ryan-vance/led-chess-board/gallery/Chess Board Final Picture.JPG

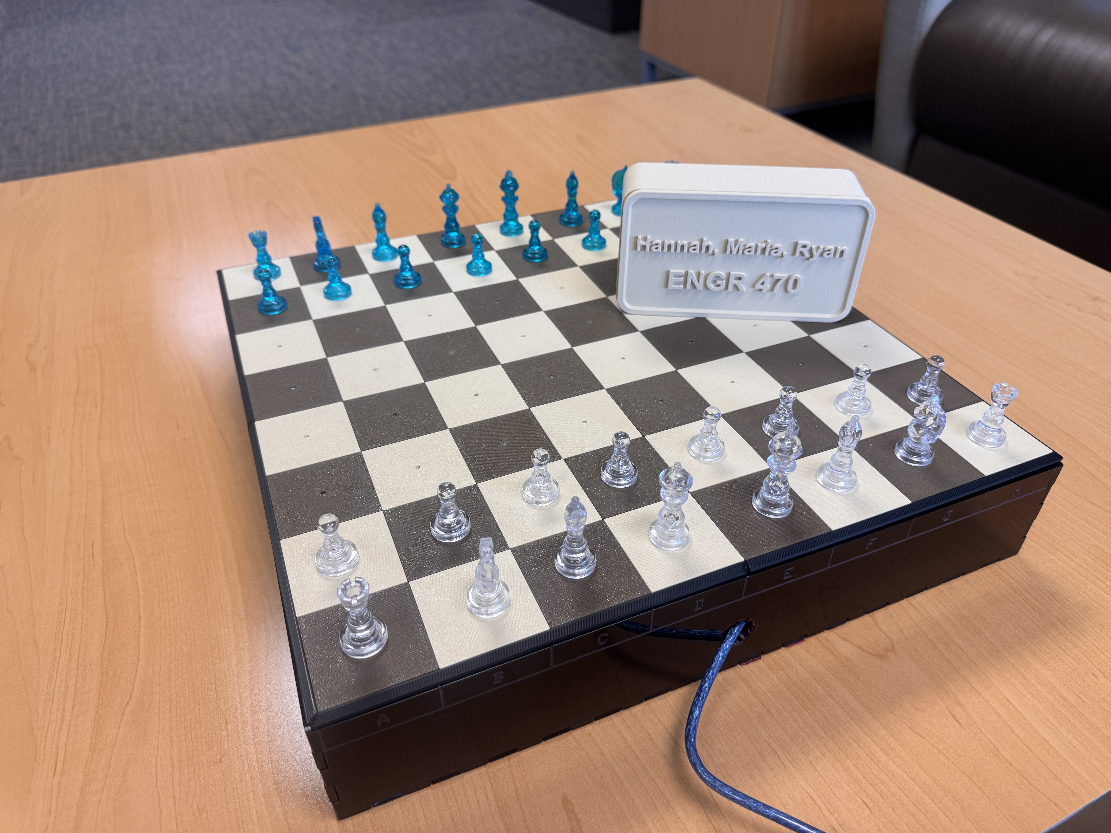
gallery/Chess Board Final Picture.JPG
