ryan-vance/led-chess-board/docs/ENGR 470 Flow Chart.png

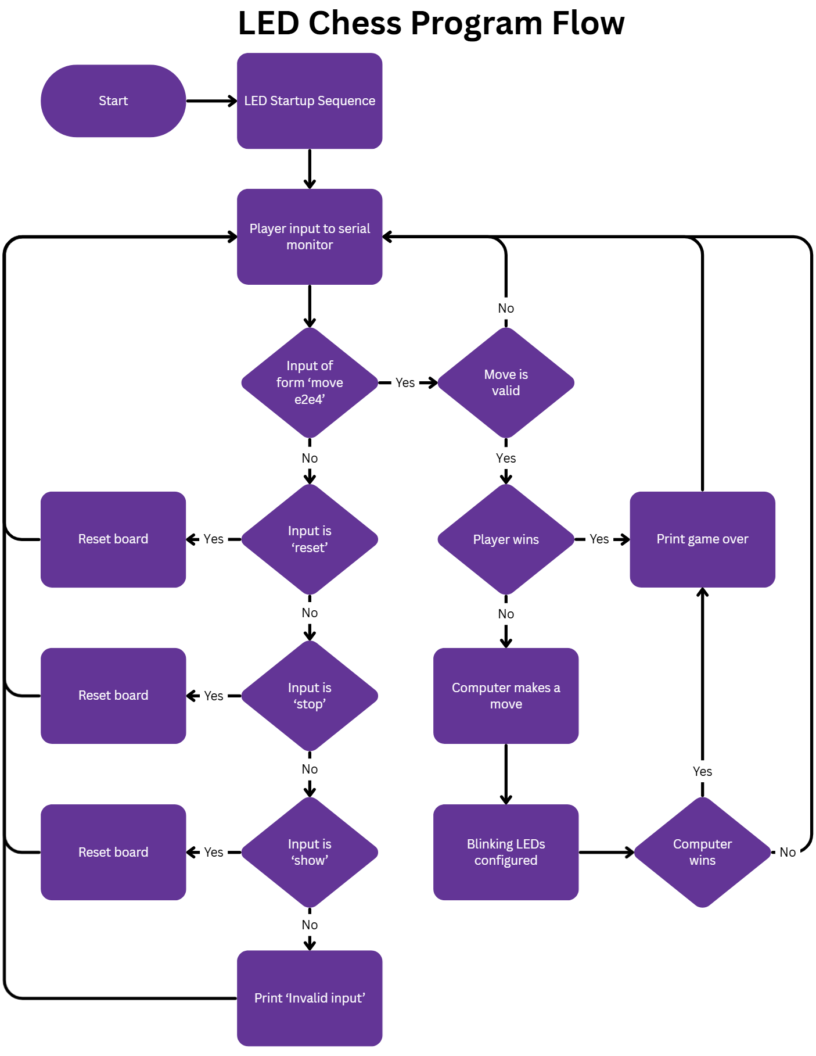
docs/ENGR 470 Flow Chart.png
