ryan-vance/led-chess-board/(commit log)

2025-12-20 Revise README for LED Chess Board project
    Updated project description and added features, hardware, and team sections.
2025-12-26 Rename IMG_6399-removebg-preview (1).png to Chess Board Wiring
2025-12-26 Rename IMG_6463.JPG to Our boards first defeat
2025-12-26 Rename Chess Board Wiring to Chess Board Wiring
2025-12-26 Rename Chess Board Circuitry.JPG to gallery/Chess Board Circuitry.JPG
2025-12-26 Enhance README with multimedia and project details
    Updated README to include videos, images, and detailed descriptions of the chess board's public engagement, design process, light brightness, and future developments.
2025-12-26 Replace chess board image with final picture
    Updated the image link for the chess board in README.
2025-12-26 Add hardware documentation for LED Chess Board
    This document provides comprehensive hardware documentation for the LED Chess Board project, including specifications, assembly instructions, and component details.
2025-12-26 Add wiring guide for LED Chess Board
    This document provides a comprehensive wiring guide for the LED Chess Board, detailing pin connections, multiplexer assignments, and testing procedures.
2025-12-26 Add Bill of Materials for LED Chess Board project
    Added a comprehensive Bill of Materials (BOM) for the LED Chess Board project, detailing core electronics, structural components, wiring, tools required, optional components, sourcing recommendations, assembly cost breakdown, component substitutions, and an inventory checklist.
2025-12-26 Update links in README for BOM and Wiring Guide
2025-12-26 Add LED Mapping documentation
    This document details the LED mapping system for a chess board, explaining how algebraic notation translates to hardware addresses for LED control. It includes an overview, mapping algorithm, complete mapping tables, usage examples, and performance considerations.
2025-12-26 Add System Architecture documentation
    This document outlines the system architecture of the LED Chess Board, detailing hardware and software integration, data flow, and subsystem descriptions.
2025-12-26 Add documentation for Multiplexer Implementation
    This document details the implementation of CD74HC4067 multiplexers to control 64 LEDs using 20 Arduino pins, covering the problem statement, multiplexer fundamentals, binary channel selection, system architecture, control logic, performance analysis, and troubleshooting.
