ryan-vance/led-chess-board/gallery/Physical Assembly Process.JPG

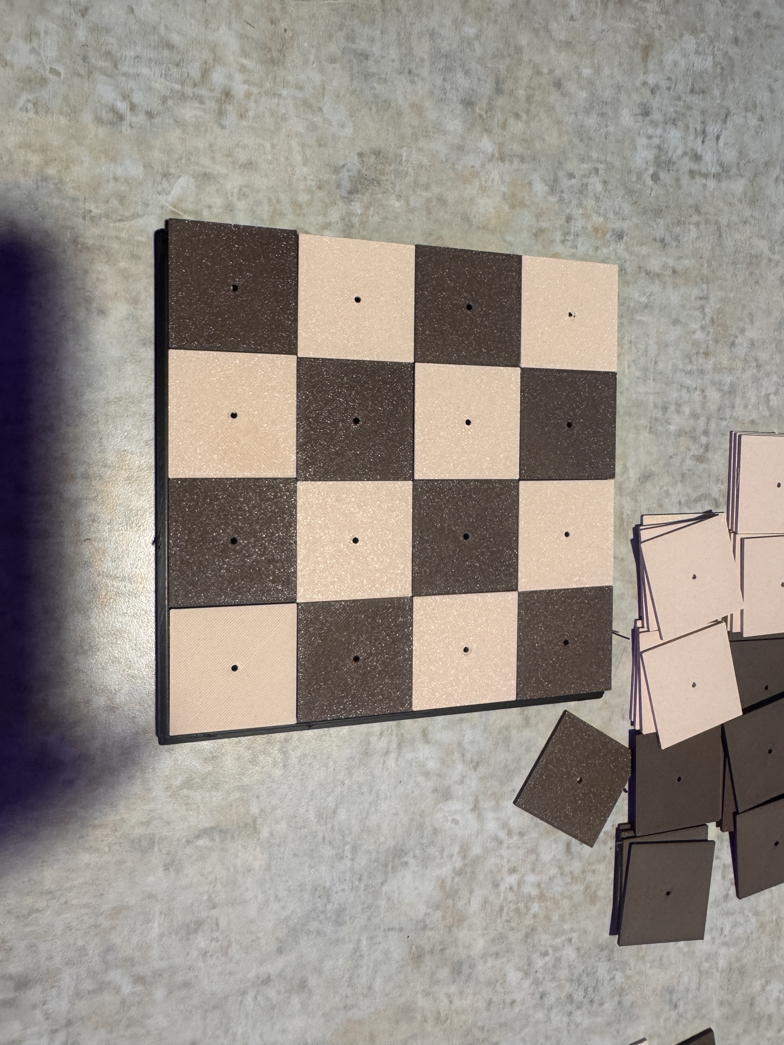
gallery/Physical Assembly Process.JPG
